Creative-Motion-Control-Course/Team-Fish/projects/project2/docs/FinalDocumentation.md

---
layout: default
---

# Development Documentation:

### CAD Work:
We began our development process by  hand embossing with a stylus and testing various 3D printed stamps on our metal surface. We continued our CAD stage of design, creating a series of rolling wheels. Here, we can see several different wheel types shown, along with a mounting plate that we designed but did not ultimately use. 

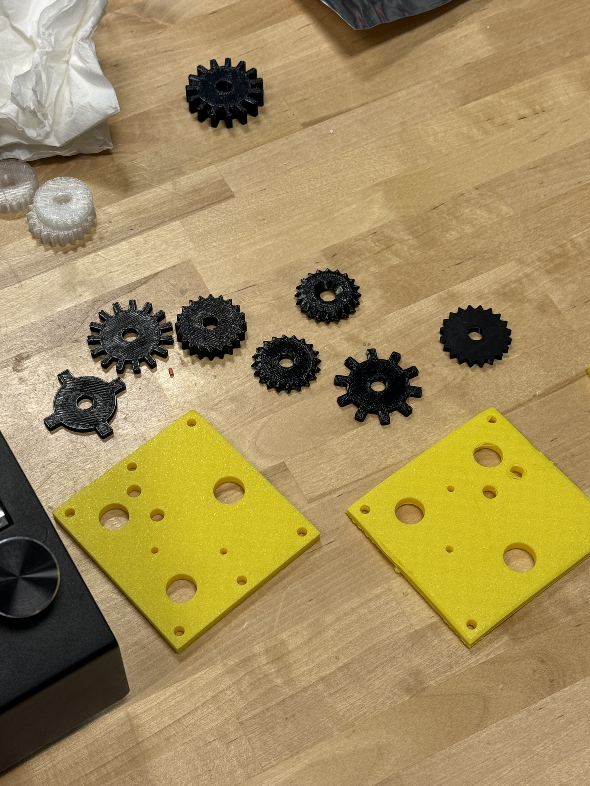
[picture p1: assets/embossingWheelsAndPlate.jpeg]
 

Then, we began to design a caster mechanism in Fusion in order to house a ball bearing and allow our custom wheels to easily pivot along the surface. This design went through several iterations, including increasing the stability of screw connections and adding an upper lip to keep the ball bearing in place. Additionally, we created a rod that the caster mechanism screws into, which is then mounted to the printer. Naturally, we also modeled several smaller rods that fit inside of the wheel and the side caster parts. Here, we show an image of the final design, as well as a short video showing the wheel effectively embossing our surface. 

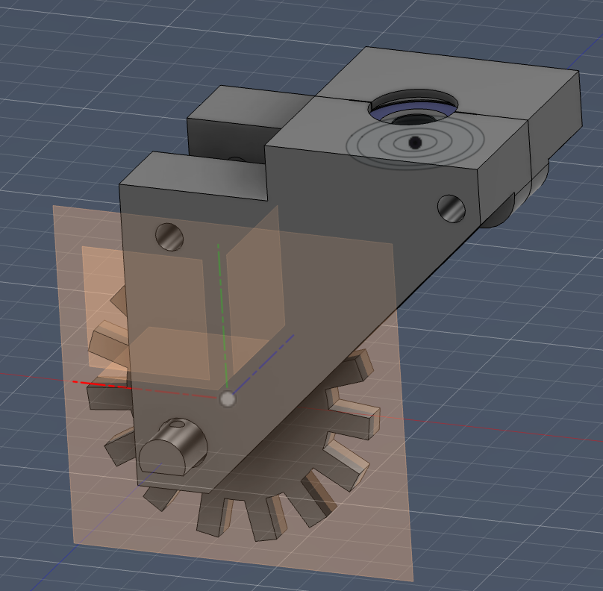
[picture p2: assets/FinalDesign.png]
 
 
<iframe width="560" height="315" src="https://www.youtube.com/embed/EgRxJ07jZb4?si=XrdXgyLfqc77kPEz" title="YouTube video player" frameborder="0" allow="accelerometer; autoplay; clipboard-write; encrypted-media; gyroscope; picture-in-picture; web-share" referrerpolicy="strict-origin-when-cross-origin" allowfullscreen></iframe>

### Hardware:
Simultaneously, we reconfigured the Ender 3D printer for our purposes. We ultimately opted to use a ballpoint pen in lieu of our embossying styluses. The rolling mechanism of the pen and lubricating pen ink allows for much smoother lines. We also used a [pre-modeled toolhead](https://github.com/AndrewSink/pltr_toolhead) that includes a spring mechanism which compensates for both the amount of force required for embossing and any surface irregularities encountered throughout the process.  

Here, we see a video of the functioning embosser being used with a ballpoint pen. 

<iframe width="560" height="315" src="https://www.youtube.com/embed/Ifee8Bci4Ek?si=R_-foS5v9JEiwPtD" title="YouTube video player" frameborder="0" allow="accelerometer; autoplay; clipboard-write; encrypted-media; gyroscope; picture-in-picture; web-share" referrerpolicy="strict-origin-when-cross-origin" allowfullscreen></iframe>

To better secure our foam surface and metal sheet, we designed and laser cut a wooden frame, which is then clamped on the perimeter of the Ender platform. Furthermore, we designed and laser cut a wooden box, assembled to mask our Stepdance board and potentiometer. See both frame and box pictured here. 

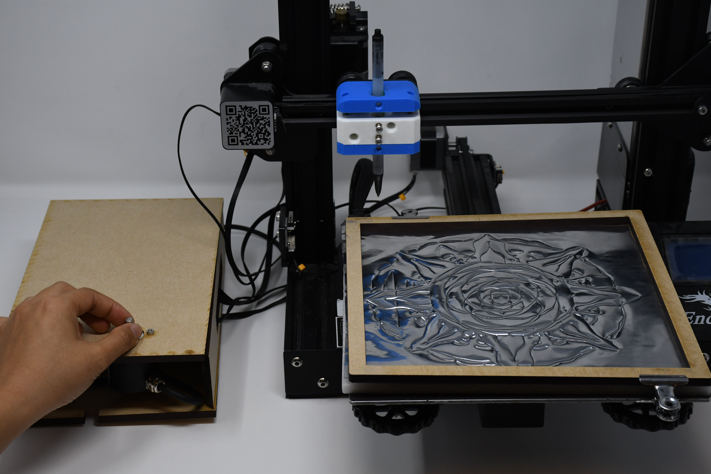
[picture p3: assets/box.JPG]


We calibrated the four corners of our platform to ensure surface regularity. We also rolled out each sheet of metal prior to clamping it in place for a smooth, flat surface. 

### UI and Frontend:
The UI was developed in p5.js, using a custom Websocket connection that sends data to the Arduino sketch. Here, the user can draw a series of lines, aided by the optional symmetry feature. Erase and Undo buttons are implemented as well. Once a design is finalized, the user presses "Send" to begin the embossing process. The points are sent in batches, spaced as necessary so as to not overwhelm the board. The user may also make adjustments to the Z-axis position to ensure the pressure level of embossing is correct with the potentiometer control. 

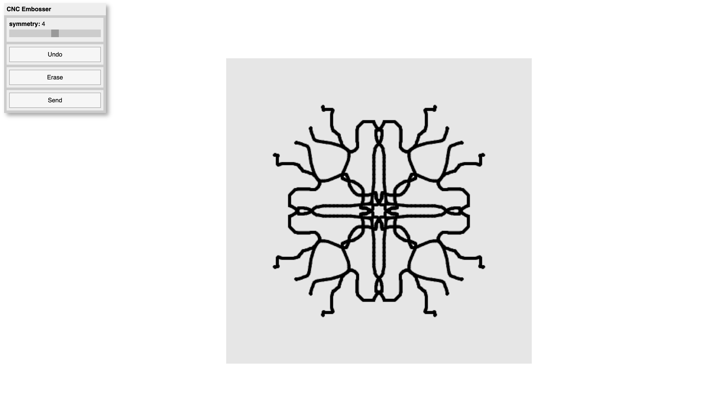
[picture p4: assets/UI.png]


# End of Year Show:
This machine was shown as part of the MAT End of Year Show in ECL. Observe the setup here -- a previously created piece is displayed, along with our finalized embossing machine, a short description of our work, and an interactive UI. 

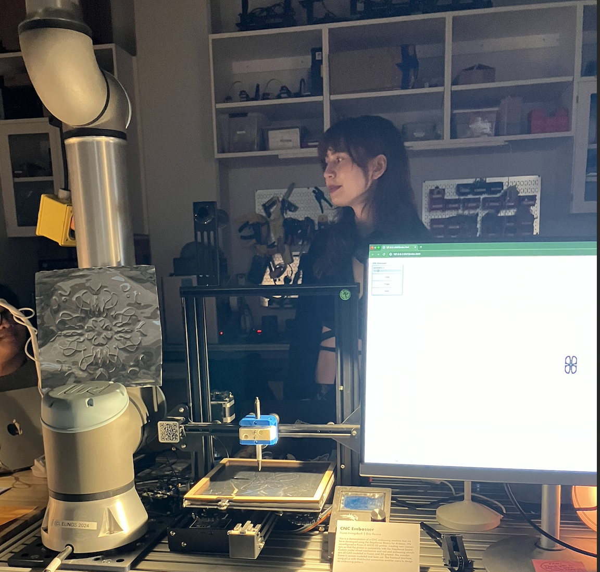
[picture p5: assets/EOYS.png]


Note that a separate monitor and mouse were used to allow attendees to create their own embossed designs. An example of a collaborative artifact that resulted are shown below. Participants greatly enjoyed using the device and were eager to learn about the mechanisms that drove it. Several sheets of metal had to be used since so many attendees wanted to try our machine. It was rewarding to interact with these viewers! Though, the mouse connection was a bit unstable at times. If we show this at any future events, we would want to be more meticulous with testing our interactive setup.  

# Resulting Artifacts:
We can start by looking at the first test artifact developed from our final hardware configuration and working UI. 

<iframe width="560" height="315" src="https://www.youtube.com/embed/5WrpiEKs30Q?si=rN3iWY7urapHSgLo" title="YouTube video player" frameborder="0" allow="accelerometer; autoplay; clipboard-write; encrypted-media; gyroscope; picture-in-picture; web-share" referrerpolicy="strict-origin-when-cross-origin" allowfullscreen></iframe>

Here, observe an artifact resulting solely from the caster mechanism using the custom dotted line wheel in naturalistic and non symmetric pathways. This is pictured alongside the wheel itself. We note that the caster wheel excels at following longer and fluid, curved paths rather than symmetrical, shorter lines as the normal pen tip does. 

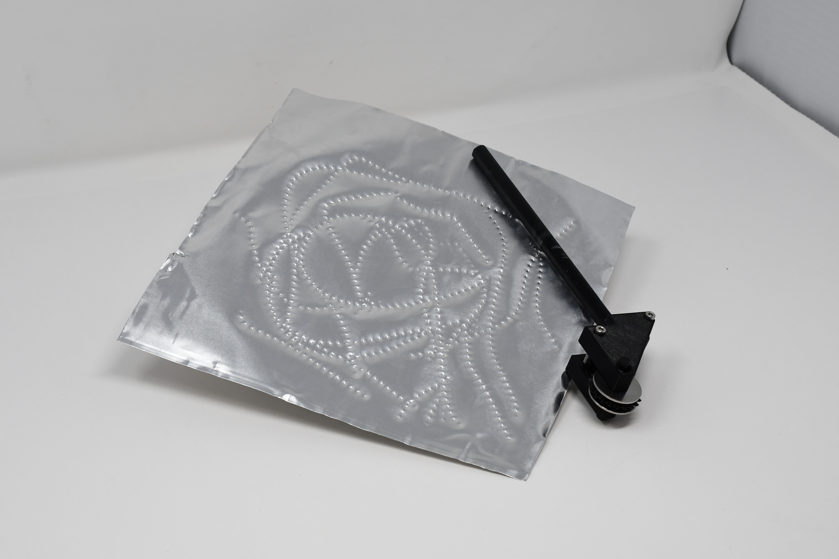
[picture p6: assets/wheelpiece.JPG]


We can also use the dotted wheel in conjunction with the normal pen tip. Here, we switch out the tip that is used mid way through the embossing process. In the future, it might be interesting to continue experimenting with using both pen types in a piece, potentially relying on pattern wheels for backgrounds (as they are often used for this purpose in the analog embossing process!). No issues emerged with the overlapping lines -- e.g. dotted wheel intersecting with prior existing pen tip line. 

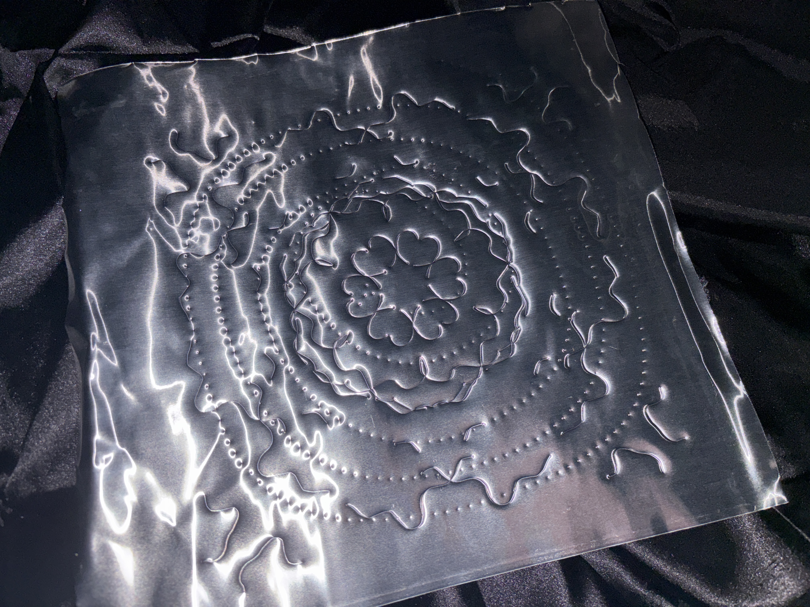
[picture p7: assets/mix.JPG]


Next we look at an artifact from the End of the Year Show, formed from many collaborative, smaller patterns. It appears to be a tapestry of different symmetry types and design concepts. We appreciate how it shows collective interaction, where each viewer builds upon the work of prior participants. This feels like a meaningful mode of creation, where a tool is demonstrated and its use by many is reflected in the finished artifact.  



Finally, here is a more refined piece that reflects our increased familiarity with the machine. This work was created after fixing some of the limits with queueing, which allowed us to fully preview the design before sending it over to the embosser (rather than building the design more slowly).  

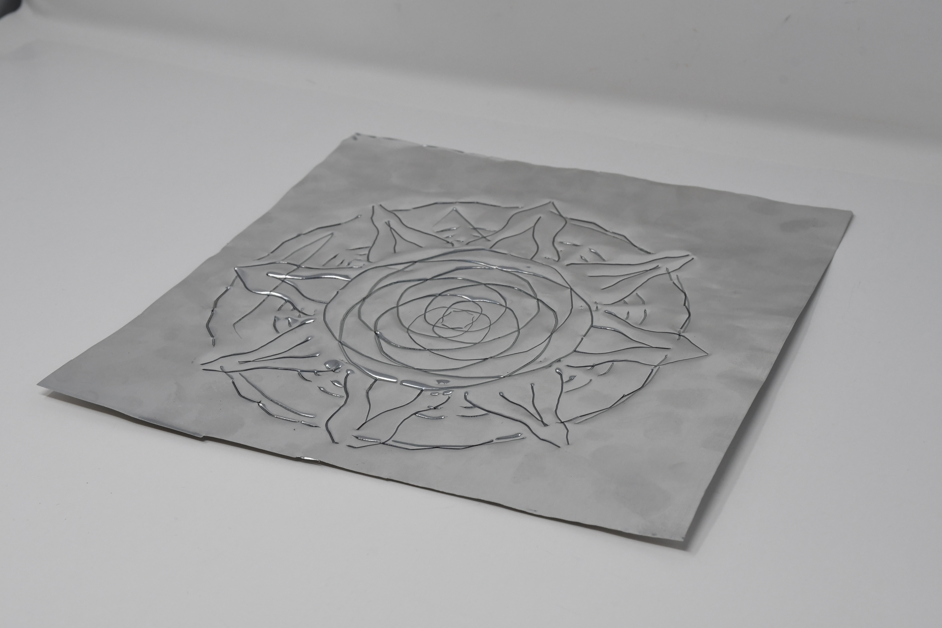
[picture p9: assets/finalartifact.JPG]


# Final Reflection:
Moving from a more unconventional, artistic approach where water level data influences the amount of Perlin noise applied to a particle that moves across a canvas, we decided to create a machine that aids and improves the craft of embossing. Two areas of standard embossing that we noticed could be improved through the collaboration of a computer are symmetry and a pre-planned path. In standard hand-embossing, it is difficult to perfectly draw the same line or pattern on several symmetrical areas of the embossing surface. It is also impossible to undo any marks made on the surface. In order to solve both of these problems, we implemented a user interface (UI) that offers users the ability to divide the canvas into equal parts determined by the symmetry slider value, and automatically apply a drawing or design to every slice through a single drawing action on the canvas. We also included an undo button which erases one stroke at a time starting from the most recent, an erase button to begin anew, and a send button to transmit the finalized drawing to the CNC machine to begin embossing. 

Beyond the UI, we used CAD to create our own embossing wheel mechanism, commonly used in embossing to create repeatable patterns on a drawing surface. We tested a variety of patterns and selected our favorites, and created a caster-based mechanism that can be rolled along the drawing surface through a pre-planned path from the UI. Additionally, we incorporated a spring-loaded mechanism that supports the embossing pen and wheels during operation, compensating for both the amount of force required for embossing and any surface irregularities encountered throughout the process. Lastly, we attached an encoder to the Stepdance board which controls z-axis height and the force applied to the embossing surface. Users can adjust the z-axis when surfaces become uneven, or if they desire more shallow or deeper indentation into the material. 

Our process was extremely involved and we pushed ourselves to complete a meaningful working prototype. In future iterations, a custom-built ballpoint embossing stylus may be preferable to a standard ballpoint pen in order to improve the visual quality of the machine itself. Additionally, we would like to revisit the embossing wheel mechanism. Due to the current caster-based implementation, fine details are often lost, as the wheel performs best when following large curves or straight lines. One potential improvement is to mount a servo motor to the CNC machine’s end effector, enabling more precise control over the embossing wheel’s orientation. By adjusting the wheel’s rotation based on the angle and slope of the toolpath generated by the UI, the system could better capture intricate details and produce more accurate embossing results. Further, we postponed the implementation of a library of preset patterns users could select and place directly on the UI canvas due to time constraints. We would like to revisit this feature in future iterations. Finally, an area of interesting feedback we received is to offer users the ability to import digital works created in Adobe Illustrator into our software which can then be sent to the embossing machine. The space of further work and improvement is essentially limitless!
