Creative-Motion-Control-Course/Team-Fish/index.md

---
layout: default
title: Home
---

# Team Fish — Creative Motion Control Course Site

## Team Members

<div style="display: flex; flex-wrap: wrap; gap: 2em; margin-bottom: 2em;">

<div style="text-align: center; max-width: 200px;">
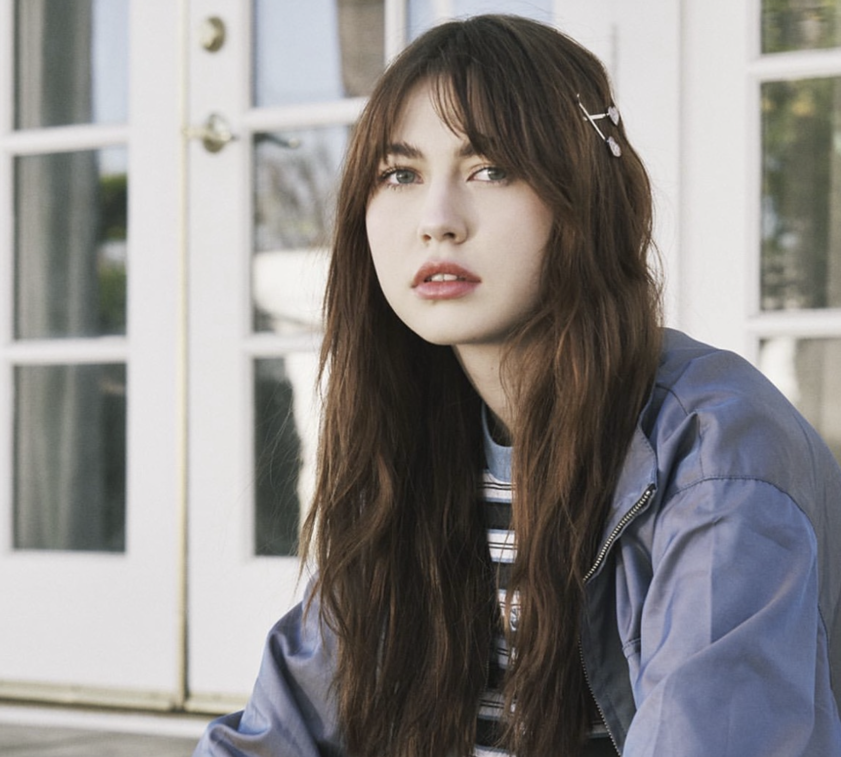
[picture p33: assets/member1.jpg]
Member 1 photo
  
  <h3>Fiona Irving-Beck</h3>
  <p><em>MS/PhD, Media Arts and Technology</em></p>
  <p>Fiona Irving-Beck is a multimedia artist with research experience in applied mathematics. They are particularly interested in using interactive media to explore the boundary between the digital and physical worlds. Fiona holds BA degrees in mathematics and studio art from Scripps College.
  
  Within Creative Motion Control, Fiona is most excited to gain hands-on experience working with CNC machines and to explore alternative modes of interaction.</p>
</div>

<div style="text-align: center; max-width: 200px;">
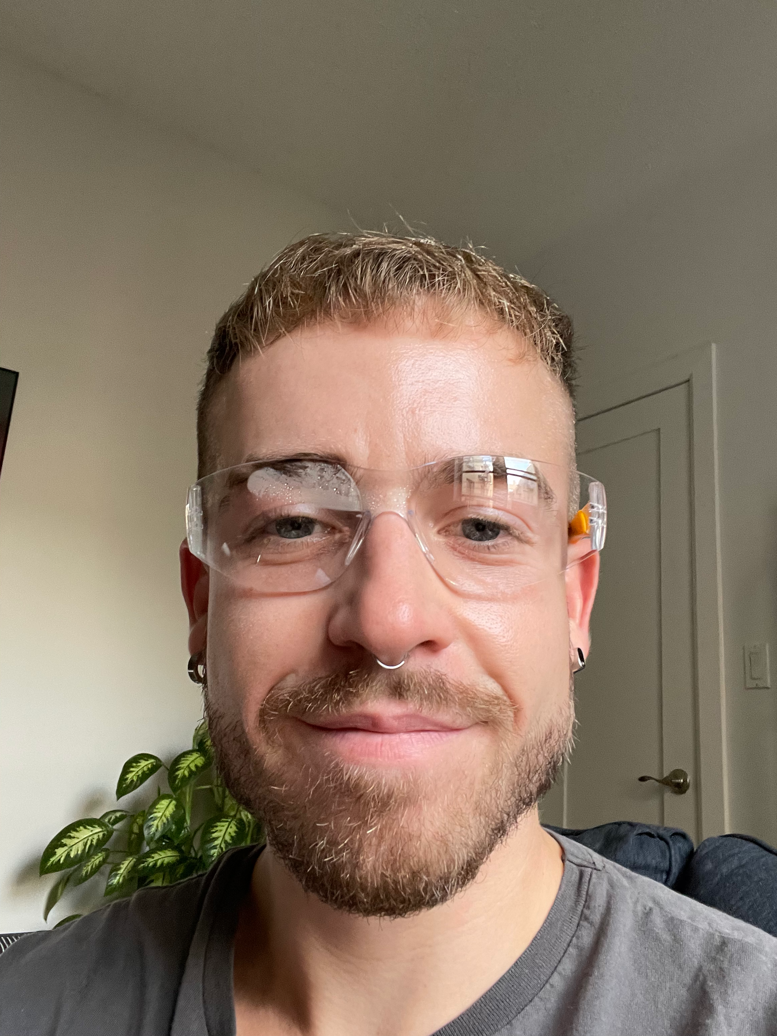
[picture p34: assets/member2.png]
Member 2 photo
  
  <h3>Eric M Rennie</h3>
  <p><em>M.S., Media Arts and Technology</em></p>
  <p><em>University of California, Santa Barbara</em></p>
  <p>Eric Rennie is a creative technologist with a background that spans media, including video and audio production, physical computing, and computer science. He joined MAT with an interest in visualizing data in unconventional ways, especially by using information from the physical world to shape these visualizations and explore new modes of human-computer interaction. His goal is to eventually collaborate with architects and engineers to design large-scale immersive environments-public, corporate, and cultural spaces that move beyond four walls and respond to environmental or contextual data, transforming the media elements that surround the observer.
  
  As a student in the Creative Motion Control course, Eric is most excited to explore embedded systems through machine modification, as well as physical computing by using sensors to drive CNC machines. He’s also interested in studying human-computer interaction to improve how people experience and use these tools.</p>
</div>

<!-- Copy the block above to add more team members -->

</div>

## Projects

<table>
  <thead>
    <tr>
      <th>Project</th>
      <th>Description</th>
    </tr>
  </thead>
  <tbody>
    <tr>
      <td><a href="projects/project1/docs/index">Project 1</a></td>
      <td>A CNC embosser that uses water level data from Santa Barbara to construct a Perlin noise field</td>
    </tr>
    <tr>
      <td><a href="projects/project2/docs/proposal">Project 2 Proposal</a></td>
      <td>A CNC machine which aims to offer the craft of embossing accuracy and symmetry that hand embossing can lack</td>
    </tr>
    <tr>
      <td><a href="projects/project2/docs/midpointReview">Project 2 Mid-Point</a></td>
      <td>Mid-Point Review of our CNC embosser</td>
    </tr>
    <tr>
      <td><a href="projects/project2/docs/PeerReview">Project 2 Peer Review</a></td>
      <td>Project 2 Peer Review of our CNC embosser</td>
    </tr>
    <tr>
      <td><a href="https://github.com/Creative-Motion-Control-Course/Team-Fish/tree/main/projects/project2/code">Project 2 Code</a></td>
      <td>Project 2 Code (UI & Arduino)</td>
    </tr>
    <tr>
      <td><a href="projects/project2/docs/FinalDocumentation">Project 2 Final Documentation</a></td>
      <td>Project 2 Final Documentation</td>
    </tr>
  </tbody>
</table>
