Creative-Motion-Control-Course/Team-Fish/(commit log)

2026-04-07 project 1 pitch description
2026-04-21 Refine documentation for project1 flowfield output
    Revised text for clarity and consistency in documentation, including adjustments to descriptions of data mapping and plotter constraints.
2026-04-21 Fix image filename case in documentation
