Creative-Motion-Control-Course/Team-Fish/assets/eoys1.JPG

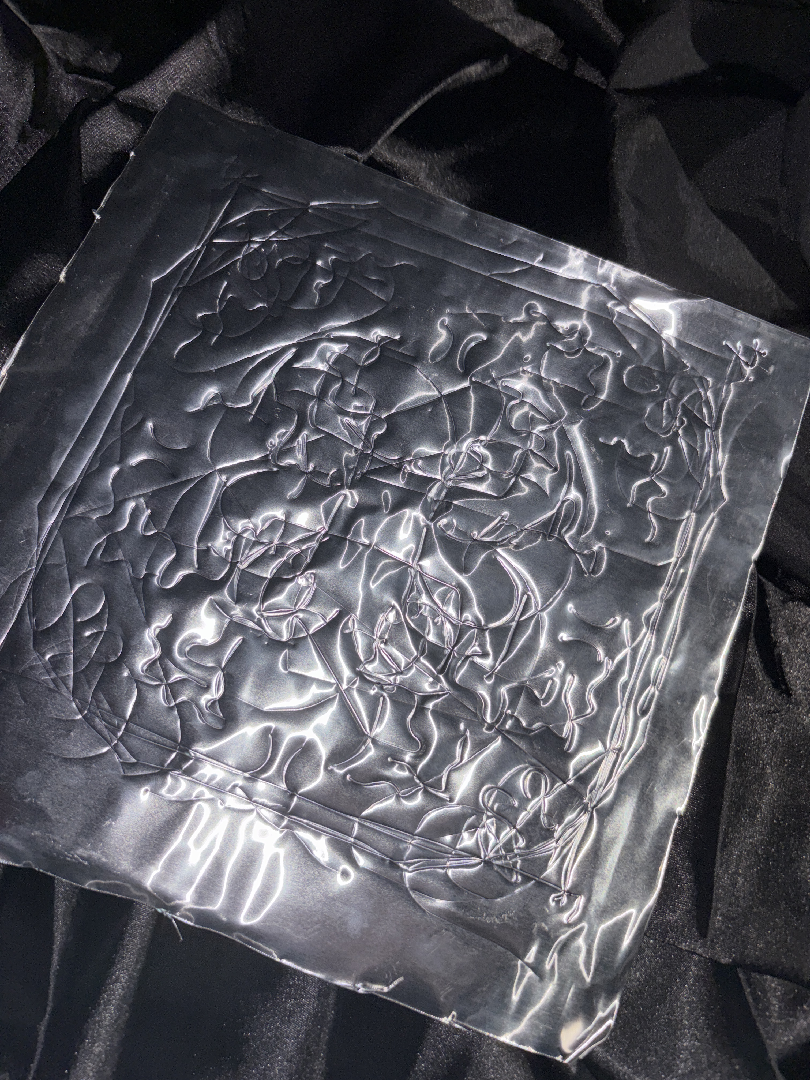
[picture p8: assets/eoys1.JPG]
assets/eoys1.JPG
